jgermain/915-MHz-Microstrip-Patch-Antenna/Images/PCB_Layout.png

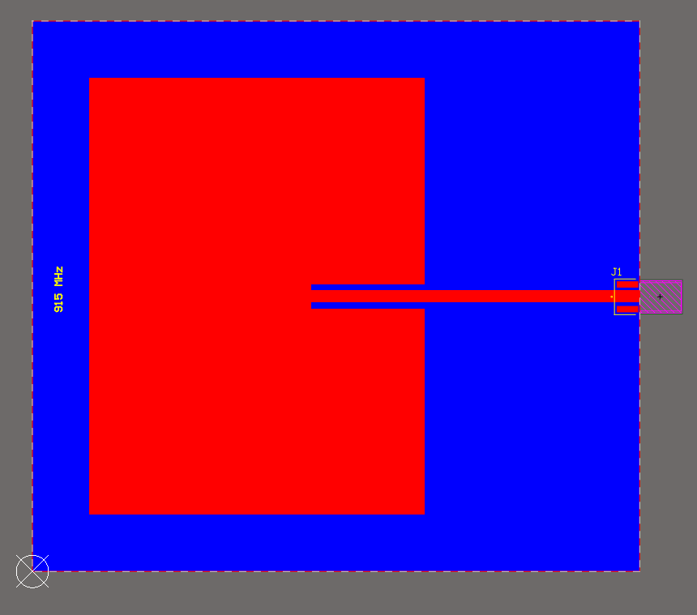
Images/PCB_Layout.png
