jgermain/915-MHz-Microstrip-Patch-Antenna/(list of files, drawings)

Other design files:
PCB/PCB.PcbDoc
PCB/PCB_Schematic.SchDoc
